GauravBhalla990/OpenSourceLidar/README.md

# OpenSourceLidar

Capstone Design Project (CSCE483 - Computer System Design): to build an open source lidar system.
