GauravBhalla990/OpenSourceLidar/Backup_Firmware/README.md

# Firmware for OpenSourceLidar - SF30C Backup Solution
Designing firmware code to flash onto Arduino and also to run ROS on Jetson to get hector slam map
through distance measurements from the SF30C and the encoder's motor speed values from the Encoder.
