GauravBhalla990/OpenSourceLidar/PCB_Firmware/README.md

# Firmware for OpenSourceLidar-OpenTOFPCB

The code in this folder details the scanning firmware to flash on to the MCU of the OpenTOF PCB through JTAG.
