GauravBhalla990/OpenSourceLidar/Backup_Firmware/Motor_encoder/README.md

# Firmware for OpenSourceLidar
Designing firmware code to run the 12V brushless DC motor
