GauravBhalla990/OpenSourceLidar/Documentation/Final/Final_Design_Presentation_Team_3N5.pdf

# Open Source LIDAR

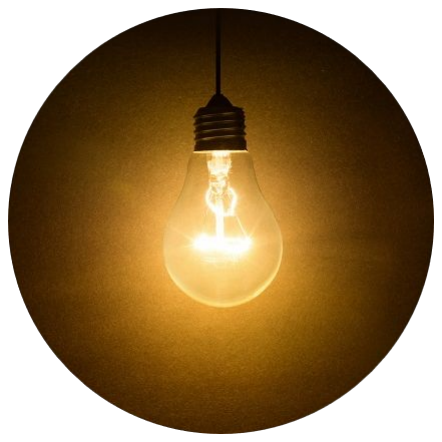
[picture p14: figure]

### Light Seekers

Paul Roy, Gaurav Bhalla, Allen Chen, Aamhish Rao

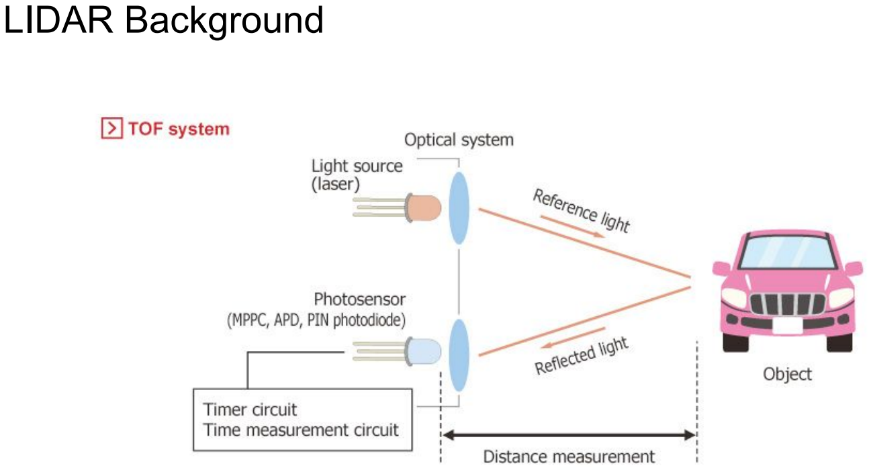
[picture p15: page 2]

### LIDAR Background

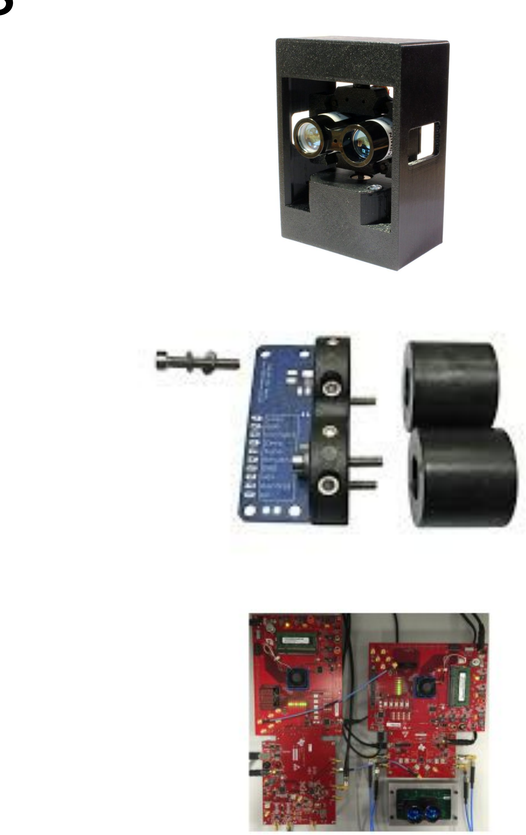
[picture p16: figure]

### Evaluation of Alternative Solutions

Xaxxon’s OpenLIDAR

OSLRF-01

TIDA-01187

Open Source LIDAR Unruly

### Problem Background

- Research group’s MEMS mirror is difficult to use.
- Commercial product do not have non-uniform sampling rate
- MEMS mirror create low and high speed areas of sampling

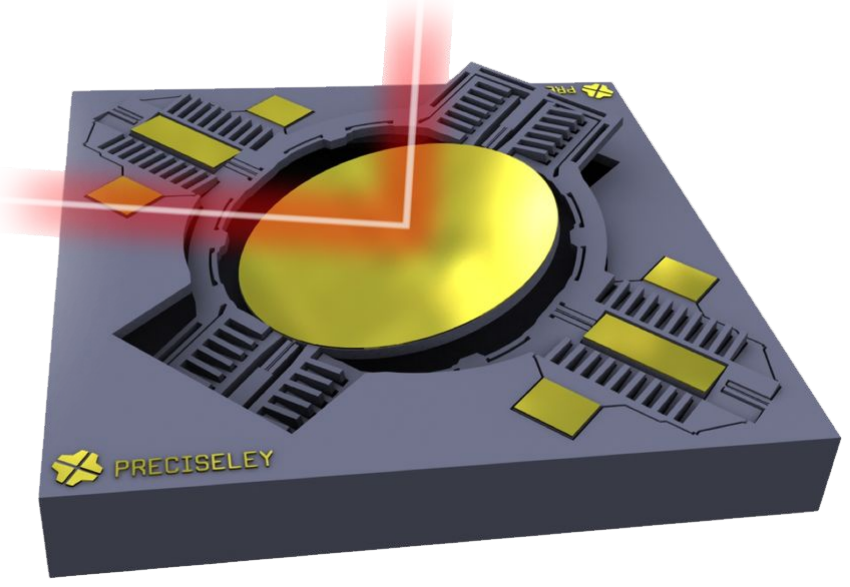
[picture p17: figure]

- We needed to copy this capability.

### Project Goals

- Recreate a working LIDAR system.
- Needed to sample space in a non-uniform manner.

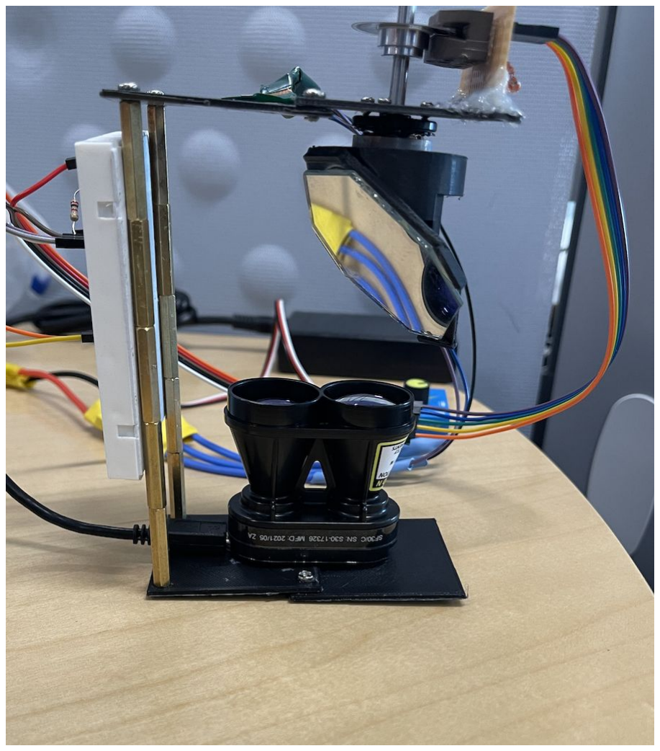
[picture p18: figure]

- Needed to create re-configurable design.

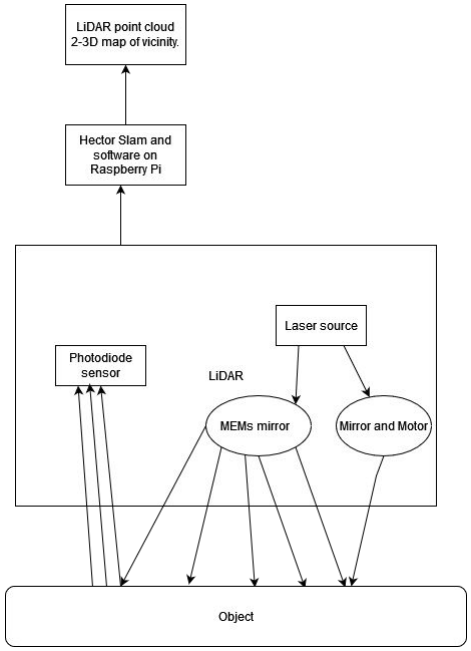
[picture p19: figure]

### System Design

- Lidar
- Laser source
- Spinning mirror
- Photodiode sensor
- Electronic and optical components

mounted on custom PCB board
- Post Processing
- Hector SLAM/ROS to read and

process lidar data

- Generate 2d/3d point cloud

### SF30C LIDAR Low Level Design

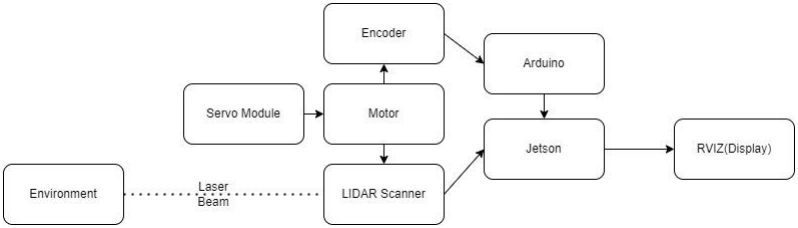
[picture p20: figure]

### Encoder

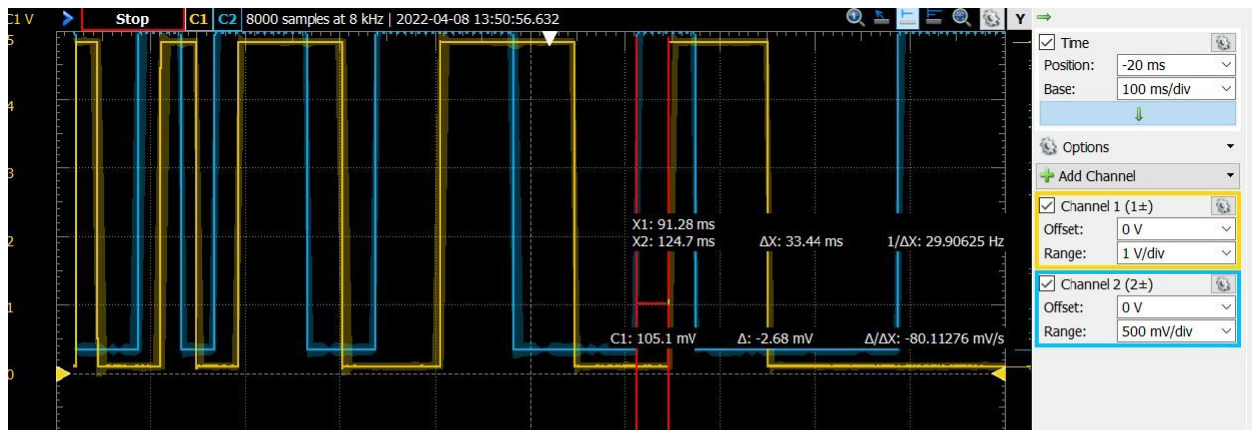
[picture p21: figure]
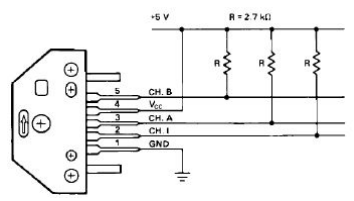
[picture p22: figure]

### Motor

- 12V LiPo Battery and ESC.

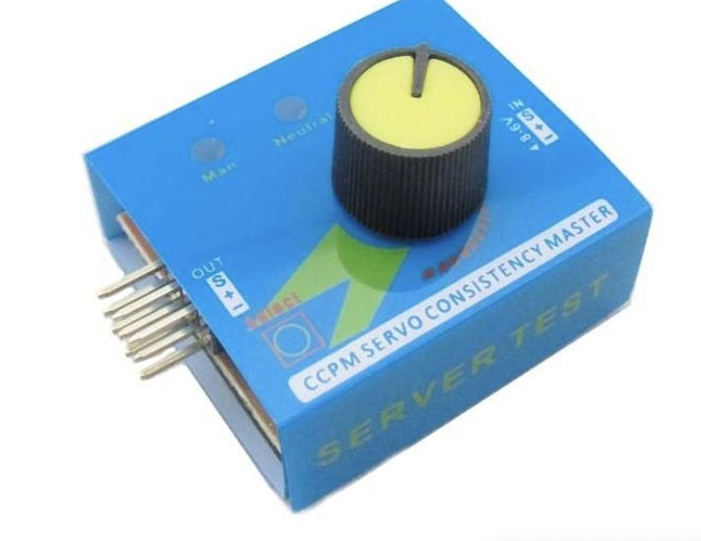
[picture p23: figure]

- Used Servo module to interface with ESC

and control motor with PWM.

- PID Loop with Encoder input and Motor

output.

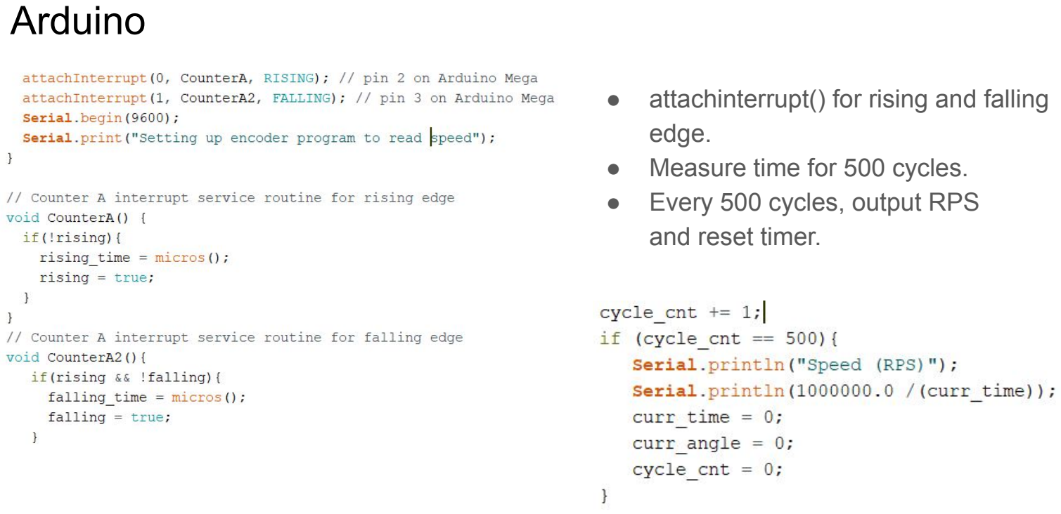
[picture p24: page 10]

### Arduino

- attachinterrupt() for rising and falling edge.
- Measure time for 500 cycles. ● Every 500 cycles, output RPS

and reset timer.

### Python ROS Programs

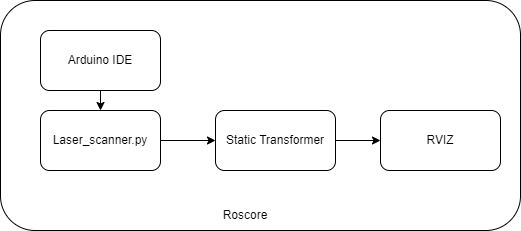
[picture p25: figure]

### LaserScanner

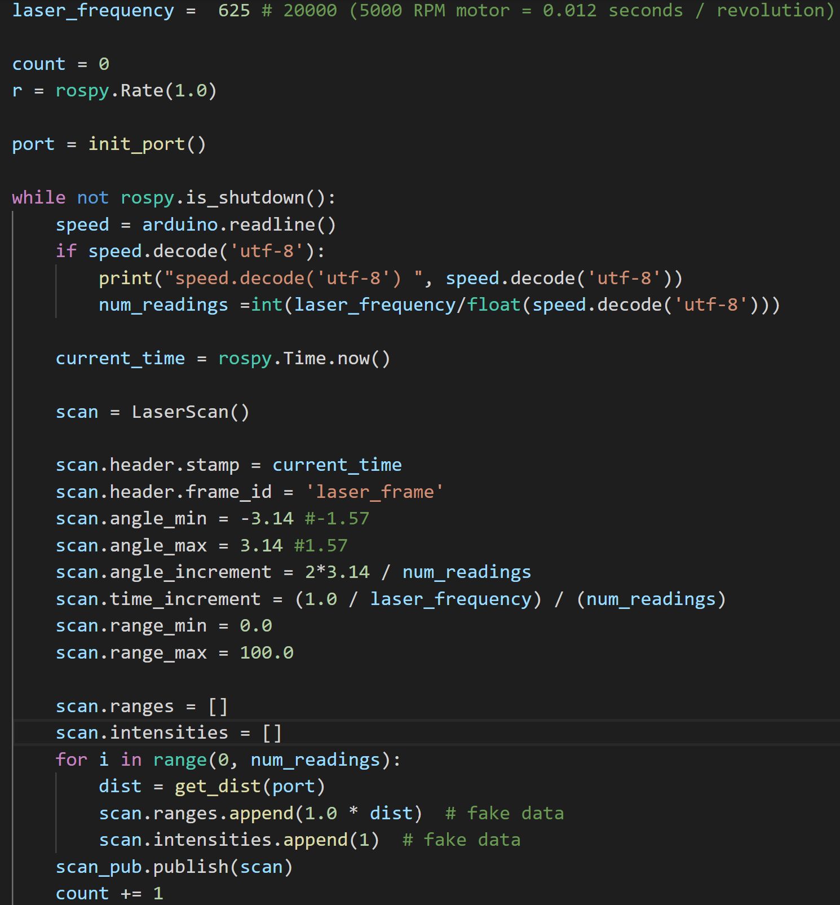
[picture p26: figure]

- Initialize serial port
- Initialize ROS node
- Receive code from Arduino and decode data
- Create laser scan message, setup params
- In readings loop append the ranges in sets
- Fill with fake data for intensities.

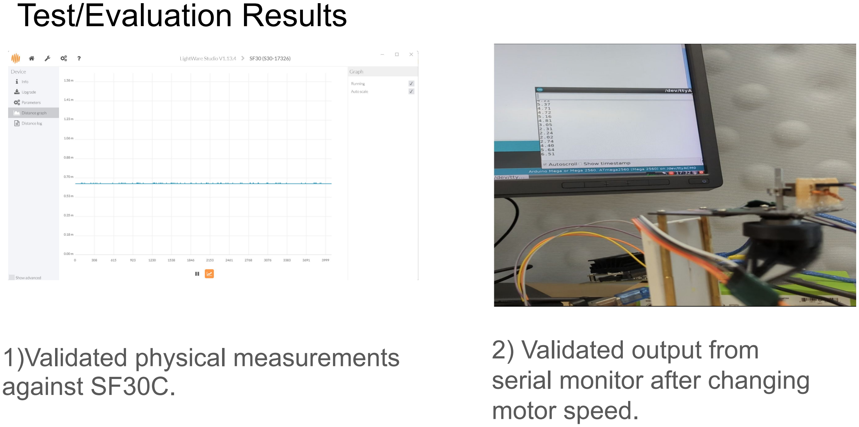
[picture p27: page 13]

### Test/Evaluation Results

1)Validated physical measurements against SF30C.

2) Validated output from
serial monitor after changing motor speed.

### Demonstration plan

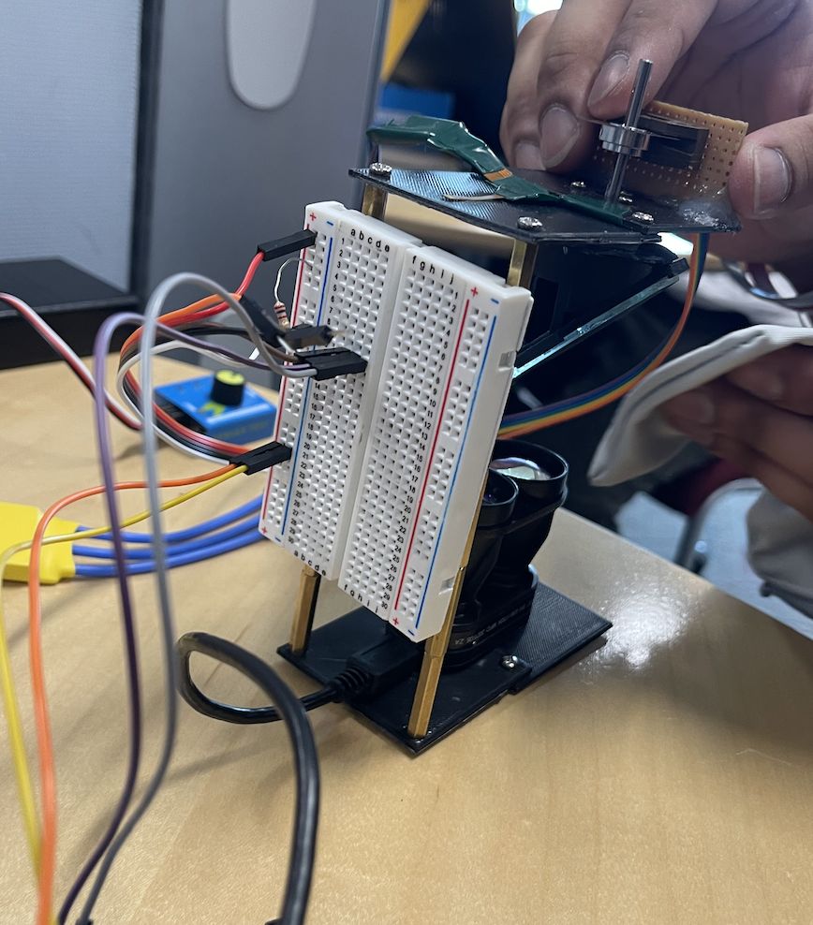
[picture p28: figure]

- Connect all of the components of the SF30

Lidar system.

- Power on battery
- Run python and arduino programs.
- Run RVIZ to see point cloud map of the

local area.

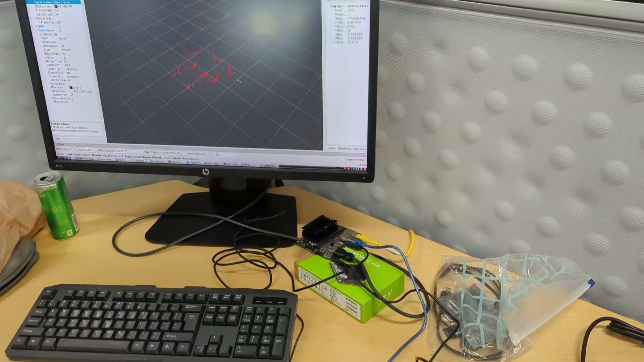
[picture p29: page 15]

### PCB Design Low Level Block Diagram

Author flashes firmware on the MCU.

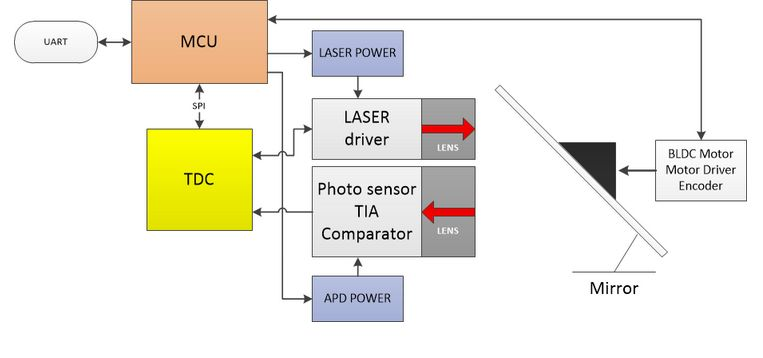
[picture p30: figure]
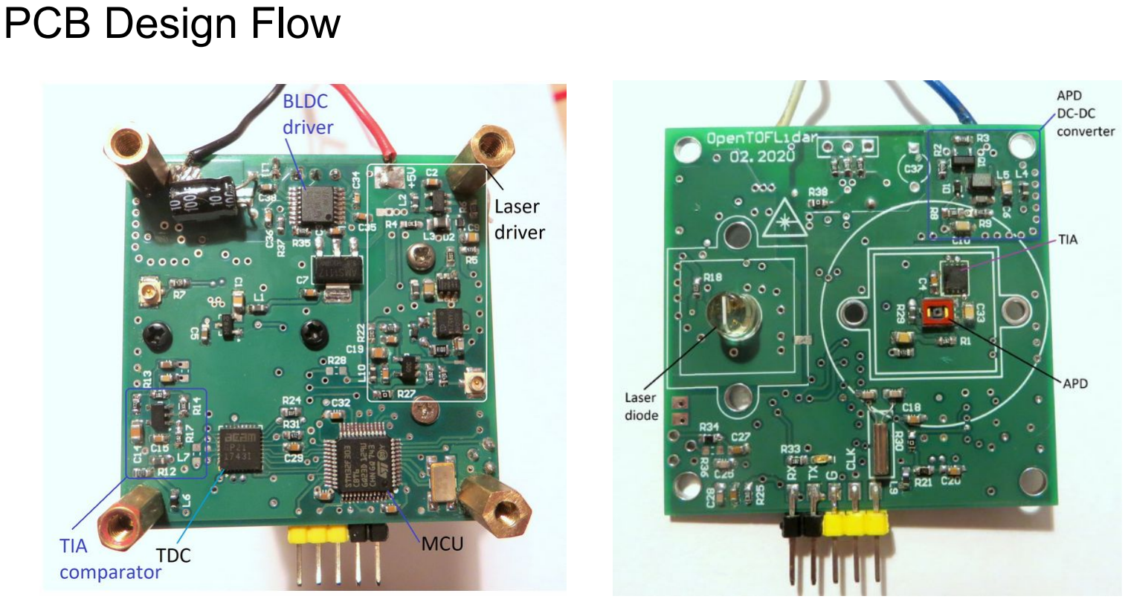
[picture p31: page 17]

### PCB Design Flow

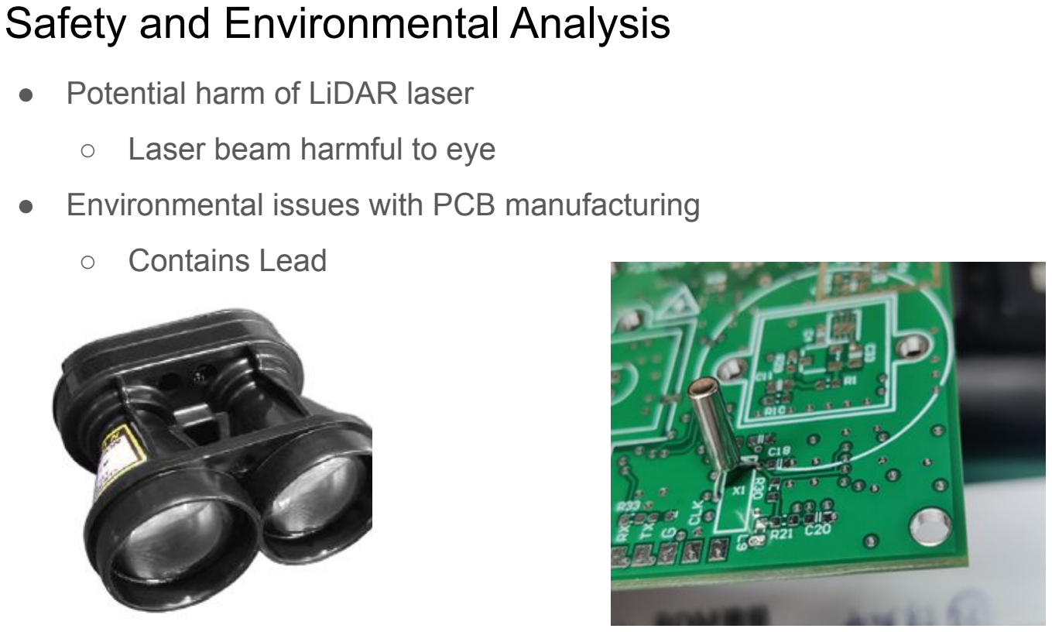
[picture p32: page 18]

### Safety and Environmental Analysis

- Potential harm of LiDAR laser
- Laser beam harmful to eye
- Environmental issues with PCB manufacturing
- Contains Lead

### Social, Political, Ethical Concerns

- Used for self-driving cars too early.

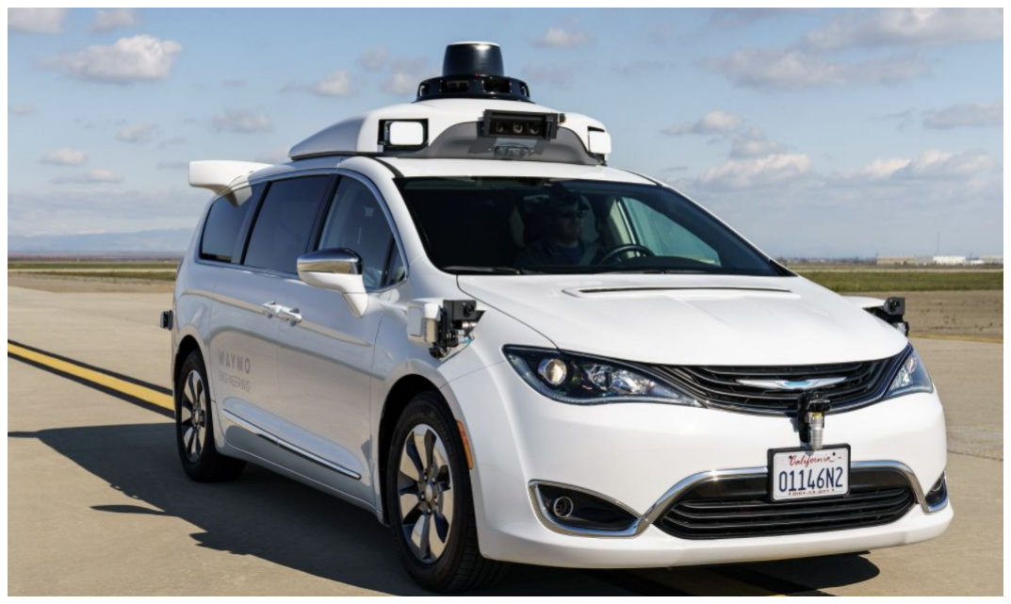
[picture p33: figure]

- Ethical, social and political issues in

Eastern Europe

- COVID outbreaks in China
- Lidar parts including the OpenTOF

PCB heavily delayed

### Manufacturability, Sustainability, and Economics

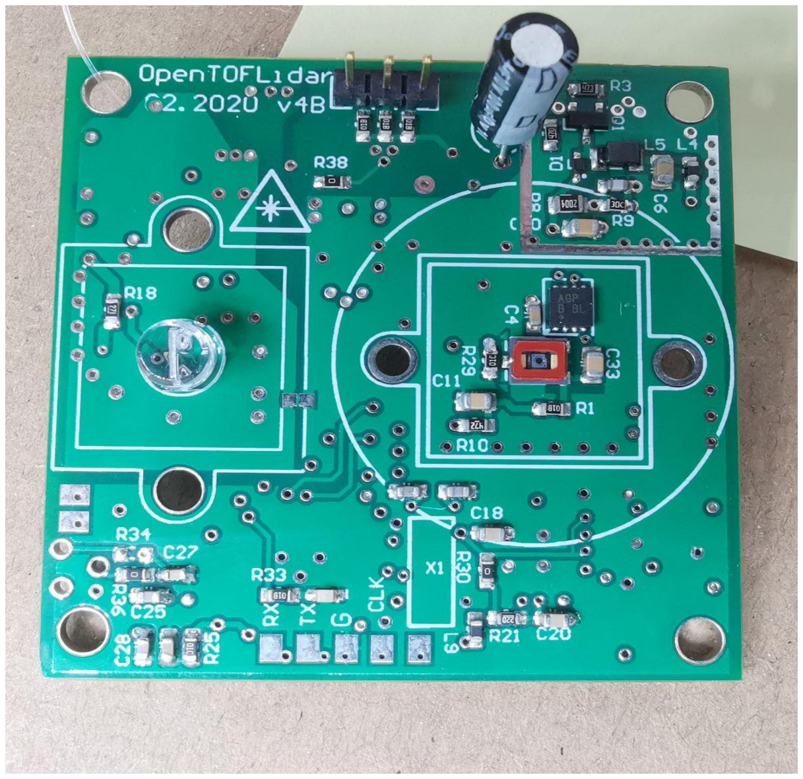
[picture p34: figure]

- PCB had a MOQ of 5.
- ~50 days to ship all PCB components.
- PCB uses some lead.
- SF30C PCB likely has lead.
- Total cost = $967.86 ($367.86 over budget)

### Project Management

- Two sub-teams: hardware and software
- Weekly meetings and occasional in-person meetings.
- Key meeting notes and weekly meeting reports
- Github

Q&A
