GauravBhalla990/OpenSourceLidar/Documentation/CDR/CDR_Presentation_Team3N5_LightSeekers.pdf

# Open Source LIDAR


## Light Seekers

Paul Roy, Gaurav Bhalla, Allen Chen, Aamhish Rao

## LIDAR Background



## Evaluation of Alternative Solutions

Xaxxon’s OpenLIDAR

OSLRF-01

TIDA-01187

Open Source LIDAR Unruly

## Problem Background

- Research group’s MEMS mirror is difficult to use.
- Commercial product do not have non-uniform sampling rate
- MEMS mirror create low and high speed areas of sampling


- We need to copy this capability

## Needs Statement

- Sample space in a non-uniform manner

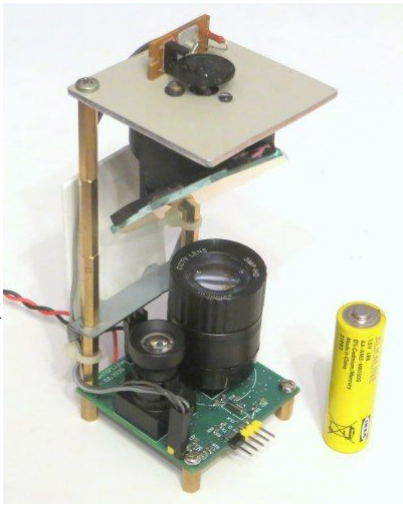
[picture p47: figure]

- Help research group to create novel LIDAR

## Goals And Objectives

Goal 1: Recreate a working Lidar system based on OpenTOFLidar

Goal 2: Develop a non-uniform sampling system

Goal 3: Create reconfigurable lidar system

## Specific Design Needs

- Increased sampling range
- Increased sampling rate

Possible Solutions for Non-uniform Sampling:

Region of Interest(ROI):

1. Uses object detection algorithms to identify areas of interest
2. Scan at a higher rate for objects expected to be more important/complex

Exciting but beyond the time scope of project.

Subsampling:

1. Scan the area once to identify general clusters
2. Scan a second time with more dynamic rates for the specific elements in the clusters themselves.

This method is simple but requires two scans to complete.


## System Design

- Lidar
- Laser source
- Spinning mirror
- Photodiode sensor
- Electronic and optical components

mounted on custom PCB board
- Post Processing
- Hector SLAM/ROS to read and

process lidar data

- Generate 2d/3d point cloud

## Low Level Block Diagram

Author configures MCU to run through the IAR Embedded Workbench.

We will flash the firmware on the MCU through Keil uVision.

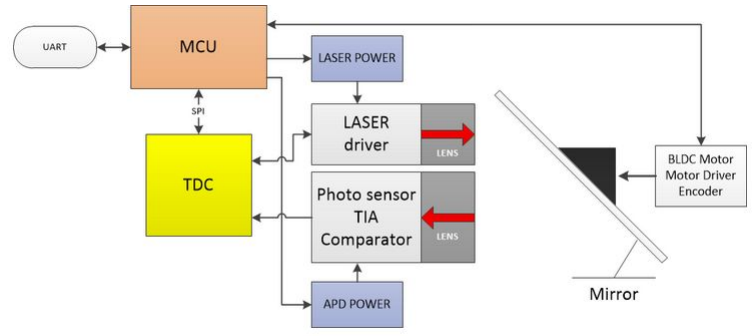
[picture p48: figure]

## PCB Design Flow (Top)

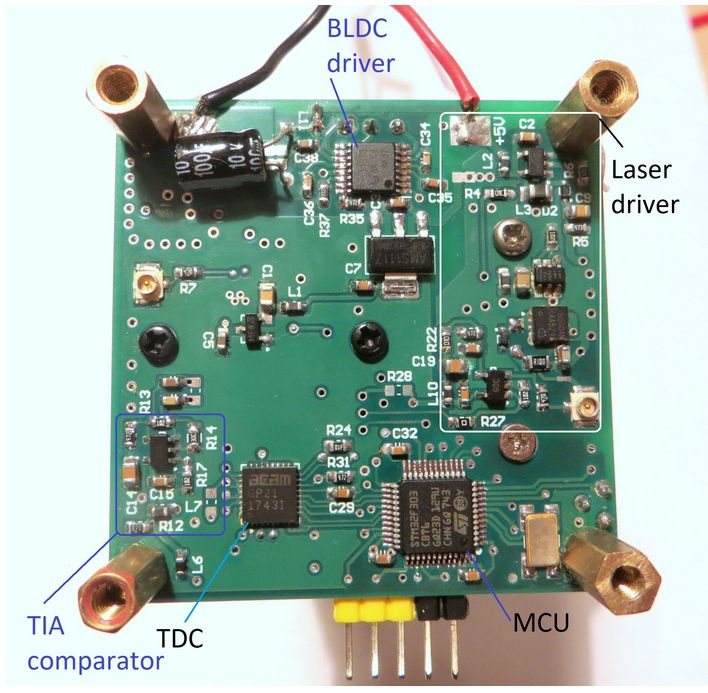
[picture p49: figure]

## PCB Design Flow (Bottom)

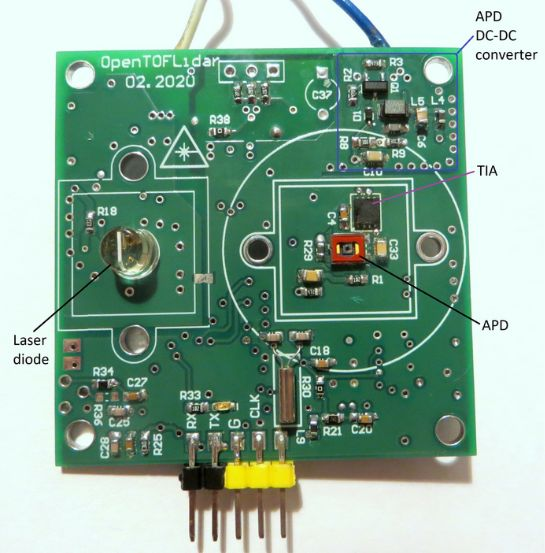
[picture p50: figure]

## Firmware


## Firmware - Main.C

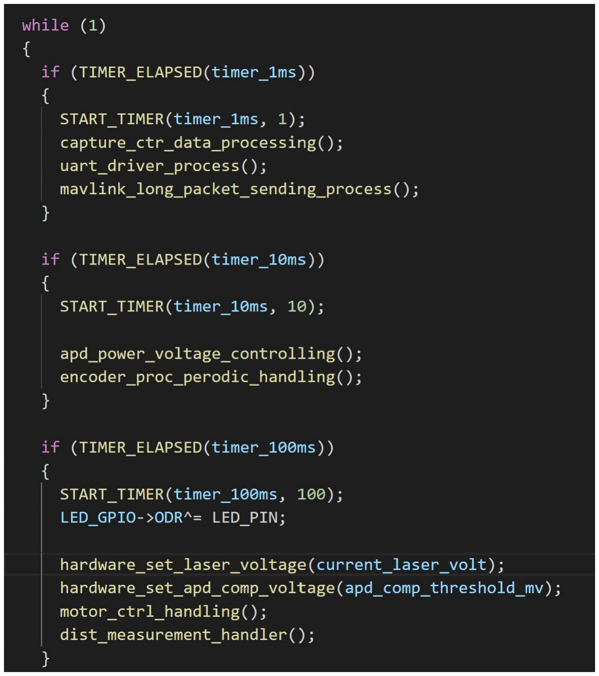
[picture p51: figure]

- Processes Data
- Sends Data through mavlink protocol
- Adjust Voltage based on light intensity
- Adjust Encoder if tick is out of range
- Flashes LED
- Sets Laser and Photodiode voltage
- Time of Flight
- Handle Motor Speeds

## Firmware - Capture_Controlling & Distance

- Captures the rotation of the encoder
- Initializes some timers for the encoder
- Keep track of the encoder periods and cycles, captures timer and encoder interrupt
- Periodically called to capture data from the lidar

## Firmware - Encoder & Motor

- Code from the Spec Sheet
- Simple Cycles for getting data from the encoder and setting PWM cycles for the motor controlling
- P loop for feedback from Encoder to control Motor

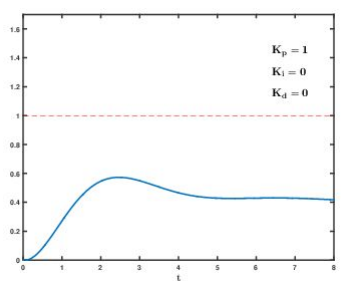
[picture p52: figure]
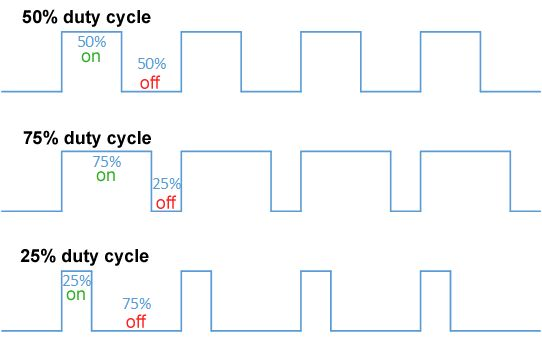
[picture p53: figure]

## Design Testing & Validation

- Test SF30C Lightware Lidar system against OpenTOF specs.
- Validate our model to Physical Distances
- Validate final design against Reference OpenTOF System
- Validate our Model’s parameters to benchmark

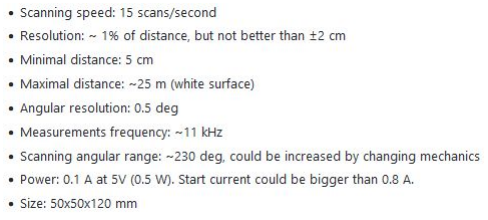
[picture p54: figure]

## Demonstration plan

1) Wear laser safety glasses.
2) Screen record laptop when code is flashed.
3) Also video record motorized spinning mirror.

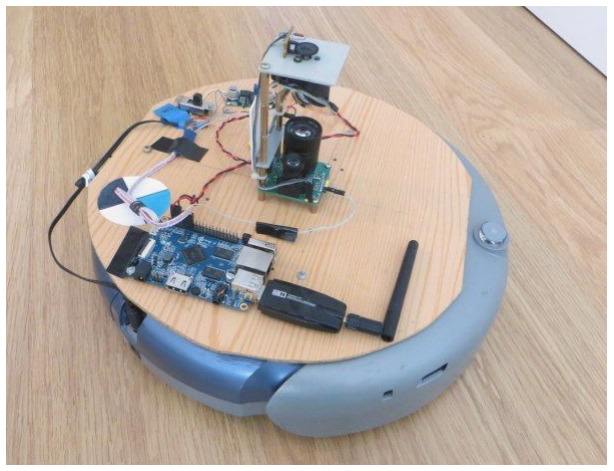
[picture p55: figure]

## Schedule of Tasks

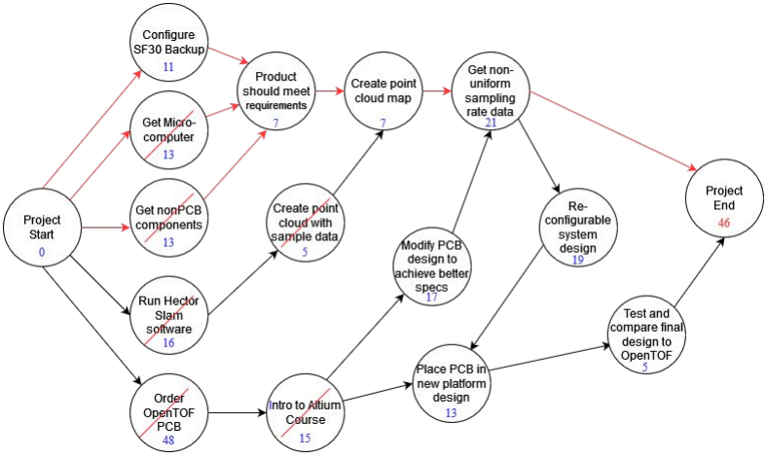
[picture p56: figure]

## Schedule of Tasks

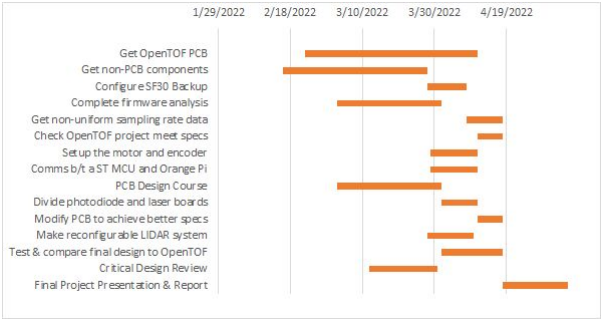
[picture p57: figure]

## Project Management and Teamwork

- Two sub-teams
- Weekly meetings and occasional in-person meetings
- Key meeting notes and weekly meeting reports
- Github

## Societal, Safety and Environmental Analysis

- Emerging applications in industry
- Potential harm of LiDAR laser
- Environmental issues with PCB manufacturing

## Social, Political, Ethical Concerns

- Used for self-driving cars too early.

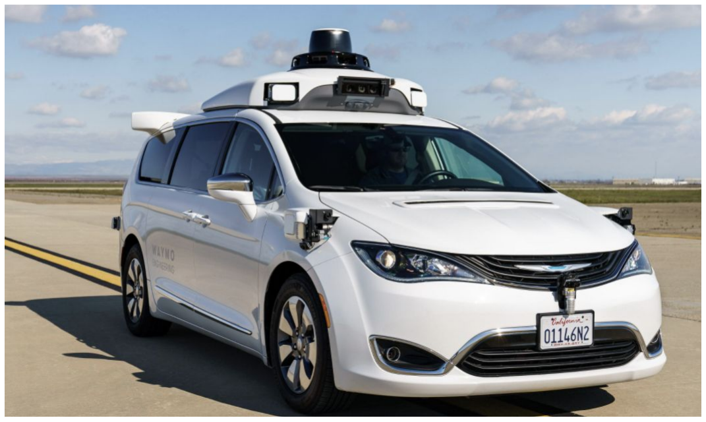
[picture p58: figure]

## Manufacturability, Sustainability, and Economics

- PCB had a MOQ of 5.
- 27 days to ship all PCB components.
- Correspondence with Engineer.
- PCB uses some lead.

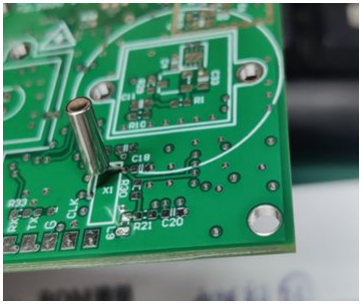
[picture p59: figure]
