GauravBhalla990/OpenSourceLidar/Backup_Firmware/old_python_ros_node/Untitled document (2).docx

https://answers.ros.org/question/371902/how-to-subscribe-to-laser-scan-topic-and-publish-a-customized-scan-topic-back/

https://gist.github.com/atotto/c47bc69a48ed38e86947b5506b8e0e61

https://python.hotexamples.com/site/file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

[ERROR] [1648931021.762483479]: [registerPublisher] Failed to contact master at [localhost:11311]. Retrying…

export ROS_MASTER_URI=http: (http://master:11311)//master:11311

https://lightwarelidar.com/products/sf40-c-100-m

~/path_to_your_workspace/devel/setup.bash

rosrun lightware_sf40_ros sf40_node /dev/ttyUSB0 115200 ?TM,360,0

terminate called after throwing an instance of 'serial::IOException'

what(): IO Exception (13): Permission denied, file /home/paul/catkin_ws/src/serial-main/src/impl/unix.cc, line 151.

Aborted (core dumped)

[ERROR] [1648936678.063308811]: Error 2 opening : No such file or directory

sudo chown paul /dev/ttyUSB0

git clone https://bitbucket.org/castacks/sf30_node.git

roslaunch sf30_node sf30.launch

http://wiki.ros.org/sf30_node

https://hackersgrid.com/2017/08/how-to-install-and-setup-linux-in-orange-pi-r1.html

https://github.com/LightWare-Optoelectronics/SampleLibrary/blob/master/sf30_arduino_serial/sf30_arduino_serial.in

#!/usr/bin/env python

2 (http://wiki.ros.org/ROS/Tutorials/WritingPublisherSubscriber%28python%29) # license removed for brevity

3 (http://wiki.ros.org/ROS/Tutorials/WritingPublisherSubscriber%28python%29) import rospy

4 (http://wiki.ros.org/ROS/Tutorials/WritingPublisherSubscriber%28python%29) from std_msgs.msg import String

5 (http://wiki.ros.org/ROS/Tutorials/WritingPublisherSubscriber%28python%29)

6 (http://wiki.ros.org/ROS/Tutorials/WritingPublisherSubscriber%28python%29) def talker():

7 (http://wiki.ros.org/ROS/Tutorials/WritingPublisherSubscriber%28python%29) pub = rospy.Publisher('chatter', String, queue_size=10)

8 (http://wiki.ros.org/ROS/Tutorials/WritingPublisherSubscriber%28python%29) rospy.init_node('talker', anonymous=True)

9 (http://wiki.ros.org/ROS/Tutorials/WritingPublisherSubscriber%28python%29) rate = rospy.Rate(10) # 10hz

10 (http://wiki.ros.org/ROS/Tutorials/WritingPublisherSubscriber%28python%29) while not rospy.is_shutdown():

11 (http://wiki.ros.org/ROS/Tutorials/WritingPublisherSubscriber%28python%29) hello_str = "hello world %s" % rospy.get_time()

12 (http://wiki.ros.org/ROS/Tutorials/WritingPublisherSubscriber%28python%29) rospy.loginfo(hello_str)

13 (http://wiki.ros.org/ROS/Tutorials/WritingPublisherSubscriber%28python%29) pub.publish(hello_str)

14 (http://wiki.ros.org/ROS/Tutorials/WritingPublisherSubscriber%28python%29) rate.sleep()

15 (http://wiki.ros.org/ROS/Tutorials/WritingPublisherSubscriber%28python%29)

16 (http://wiki.ros.org/ROS/Tutorials/WritingPublisherSubscriber%28python%29) if __name__ == '__main__':

17 (http://wiki.ros.org/ROS/Tutorials/WritingPublisherSubscriber%28python%29) try:

18 (http://wiki.ros.org/ROS/Tutorials/WritingPublisherSubscriber%28python%29) talker()

19 (http://wiki.ros.org/ROS/Tutorials/WritingPublisherSubscriber%28python%29) except rospy.ROSInterruptException:

20 (http://wiki.ros.org/ROS/Tutorials/WritingPublisherSubscriber%28python%29) pass

http://cobecoballes-robotics.blogspot.com/2018/08/laserscan-ros-arduino.html

scan.header.frame_id = 'laser'

scan.header.stamp = get_most_recent_timestamp(rf, sg)

scan.angle_min = angle_min

scan.angle_max = angle_max

scan.angle_increment = angle_increment

scan.scan_time = time.time() - last_scan_time

scan.time_increment = scan.scan_time / 541

scan.range_min = rf.range_min

scan.range_max = rf.range_max

scan.ranges = rf.ranges

for i in range(180*2):

if sg.ranges[i] < scan.ranges[90 + i] or scan.ranges[90 + i] == 0:

scan.ranges[90 + i] = sg.ranges[i]
