GauravBhalla990/OpenSourceLidar/Documentation/Final/Bill_of_materials_team3N5.xlsx

IGNORE ITEMS HIGHLIGHTED IN YELLOW AS THEY WERE INCLUDED IN THE PCB COST | No. | Name | Retail Price $ | Description | Taobao Price ¥ | Note | Taobao URL | URL
PCB components | 1 | AD500-8 | $10.40 | Chinese Avalanche photodiode (proved in real device), TO-52 package. Original photodiode costs $180 at Mouser | 65 |  | 【淘宝】https://m.tb.cn/h.fPxuv8d?tk=ZQRx23eDqGc「AD500-8雪崩光电二极管 TO52S1 激光测距用 AD500-8 TO52S1雪崩管」 | https://aliexpress.com/item/1298052194.html
 | 2 | SPL PL90_3 | $9.44 | Pulsed Laser Diode | 59 |  | 【淘宝】https://m.tb.cn/h.fmx7VW4?tk=7Ohx23eBbI5「SPLPL90-3 SPL PL90-3 脉冲激光二极管 75W 905NM 全新原装进口」 | https://aliexpress.com/item/32817685030.html
 | 3 | MAX3658 | $4.80 | Transimpedance Amplifier | 30 |  | 【淘宝】https://m.tb.cn/h.fmTBQiq?tk=lJuv23GNy9B「MAX3658AETA MAX3658 TDFN-8 芯片」 点击链接直接打开 | https://www.digikey.com/product-detail/en/maxim-integrated/MAX3658AETA-T/MAX3658AETA-TCT-ND/5404197
 |  |  | $0.00 | (22$ for 5 pcs) |  |  |  | https://www.ebay.com/itm/5PCS-MAX3658AETA-T-IC-AMP-TRANSIMPEDANCE-8-TDFN-MAX3658-3658-MAX3658A-3658A-MAX3/192826918497
 | 4 | ADCMP600 x 2 | $3.20 | Fast Comparator, two IC | 20 |  | 【淘宝】https://m.tb.cn/h.fNTNldS?tk=SumS23GM1U6「ADCMP600BRJZ ADCMP600BKS ADCMP600BRJ ADCMP600 SOT23-5 芯片」 点击链接直接打开 | https://www.digikey.com/product-detail/en/analog-devices-inc/ADCMP600BKSZ-REEL7/ADCMP600BKSZ-REEL7CT-ND/1246113
 |  |  | $6.08 |  | 38 |  | 【淘宝】https://m.tb.cn/h.fmTBgEM?tk=ntUm23GoMYd「雷顿 ADCMP600BKSZ ADCMP600 丝印G0C SC70-5线性比较器 原装」
 | 5 | UCC27511DBVR | $3.81 | Mosfet Driver | 23.8 | 10 pc | 【淘宝】https://m.tb.cn/h.flTAGAP?tk=ANQL23GKzja「UCC27511DBVR UCC27511DBV UCC27511DBVT 7511 全新正品可拍」 点击链接直接打开 | https://www.digikey.com/product-detail/en/texas-instruments/UCC27511DBVR/296-30285-1-ND/3060762
 |  |  | $16.00 |  | 100 |  | 【淘宝】https://m.tb.cn/h.fNToX5Y?tk=lxC623GpOpJ「原装正品 UCC27511DBVR 封装SOT-23-6 丝印7511 MOS驱动器 贴片」 点击链接直接打开
 | 6 | TDC-GP21 | $2.00 | Time-to-Digital converter IC | 12.5 |  | 【淘宝】https://m.tb.cn/h.fm6ZTNL?tk=IHoA23GJb8n「TDC-GP21 丝印:GP21 QFN-32 流量传感芯片 传感器探测器接口IC」 点击链接直接打开 | https://www.ebay.com/itm/1pcs-TDC-GP21-GP21-new/292575333067
 | 7 | STM32F303CBT6 | $8.48 | MCU | 53 |  | 【淘宝】https://m.tb.cn/h.fNTpQoi?tk=hQdW23GJp2G「全新原装STM32F303CBT6 LQFP-48 ARM Cortex-M4 32位微控制器-MCU」 点击链接直接打开 | https://www.digikey.com/product-detail/en/stmicroelectronics/STM32F303CBT6/497-17421-ND/4357226
 | 8 | DRV11873PWPR | $6.40 | DLDC driver DRV11873 | 40 |  | 【淘宝】https://m.tb.cn/h.fOUwAur?tk=aoGC23GIgGm「DRV11873PWPR DRV11873PW DRV11873 封装HTSSOP16 全新原装」 点击链接直接打开 | https://ru.mouser.com/ProductDetail/Texas-Instruments/DRV11873PWPR
 |  |  | $0.00 | DLDC driver DRV11873 (China, 1$) |  |  |  | https://aliexpress.com/item/33010069942.html
 | 9 | BSZ165N04NS G | $0.40 | Fast MOSFET | 2.5 |  | 【淘宝】https://m.tb.cn/h.fOUwCbQ?tk=BHUU23GIsqJ「BSZ165N04NS G 165N04N MOSFET 40V/31A SON-8 进口原装 支持配单」 点击链接直接打开 | https://ru.mouser.com/ProductDetail/Infineon-Technologies/BSZ165N04NSGATMA1
 | 10 | Additional PCB components | $8.00 |  | 50
 | 11 | PCB Itself | $2.40 | 4 Layer PCB, price for 5 boards (<50x50mm) | 15 |  |  | https://jlcpcb.com
 |  |  | $0.00
 | 12 | Photodiode Lens | $4.48 | Lens, CS mount, 25mm focal length, F1.2 | 28 |  |  | https://aliexpress.com/item/32303375838.html
 | 13 | CS lens holder | $0.24 | Holder for CS lens | 1.5 |  | 【淘宝】https://m.tb.cn/h.fNTqmms?tk=SyBE23GHtNo「CS金属镜头底座20mm安装孔距安防监控摄像机配件CS镜头座」 点击链接直接打开 | https://aliexpress.com/item/32815023477.html
 | 14 | BLDC motor | $0.64 | BLDC, outrunner, 20mm diameter, KV > 200 | 4 |  | 【淘宝】https://m.tb.cn/h.fm6chvO?tk=733o23GF56t「【仓兴达】高速云台电机 2010 无刷电机 KV值2500 滚珠轴承」 点击链接直接打开 | https://aliexpress.com/item/4000323714513.html
 | 15 | Scanning Mirror | $1.60 | Customized shape, Alum, front surface mirror (12$ for 4 mirrors) | 10 |  | 【淘宝】https://m.tb.cn/h.fOUAm6T?tk=S1yH23Gw2a1「无框大块钢化玻璃镜子定制切割鞋柜玻璃镜面定做防爆贴墙小镜子片」 点击链接直接打开 | https://aliexpress.com/item/4000246071735.html
 |  |  | $4.80 | soft mirror | 30 |  | 【淘宝】https://m.tb.cn/h.fl63whX?tk=HLhs23Gx2ry「软镜子 超薄手工镜子diy材料镜子贴安全不碎非玻璃软镜子可剪切」
 | 16 | Stand-offs | $1.28 | 25mm M3 Hex Stand-off x 8, price for 20pcs | 8 | 10 male | 【淘宝】https://m.tb.cn/h.fl6V45D?tk=5gSm23GBfNx「六角铜柱 单头铜螺柱 25mm铜柱 隔离机箱铜柱 铜柱螺母 铜柱M3」 点击链接直接打开 | https://www.aliexpress.com/item/4000449592477.html
 |  |  | $0.24 |  | 1.5 | 5 female | 19微子那可地有一小多着这为信 https://m.tb.cn/h.fNTG5K5 ~这个商品很不错，我还有一张【3】元，限量优惠I券送给你，快来看看！【(5个)M3*25mm 双通六角铜柱 电脑机箱主板螺丝母杆钉子紧固隔离】
 |  | Stand-offs | $0.00 | 10mm M3 Hex Stand off
 | 17 | Laser lens | $4.80 | 25mm M12 F2.0 lens (Free delivery) | 30 |  | 【淘宝】https://m.tb.cn/h.fNTuGhR?tk=SI0h23uZAjO「500万高清镜头4mm6mm8mm12mm16mm25mm1/2.5英寸M12口监控器材配件」 点击链接直接打开 | https://aliexpress.com/item/32913215547.html
 |  |  | $2.96 |  | 18.5 |  | 【淘宝】https://m.tb.cn/h.fl6U6sX?tk=zIgO23u0t1z「3MP 25mm小镜头300万25MM数字高清镜头M12单扳机25毫米远焦镜头」 点击链接直接打开
 |  |  | $2.88 |  | 18 |  | 【淘宝】https://m.tb.cn/h.fm64kBz?tk=mevI23ub0ty「25mm高清监控摄像机定焦镜头单板机红外镜头长焦镜头m12镜头」
 | 18 | Laser lens holder | $0.16 | Plastic holder, 10mm height, 20mm hole distance (price for 10pcs) | 1 |  | 【淘宝】https://m.tb.cn/h.fNTvrDI?tk=J19J23u1Ypu「M12镜头座20mm安装孔距7 8 10 14 15mm高塑钢金属塑料小镜头座」 点击链接直接打开 | https://aliexpress.com/item/32953675441.html
 |  |  | $0.16 |  | 1 |  | 【淘宝】https://m.tb.cn/h.fNTvrDI?tk=J19J23u1Ypu「M12镜头座20mm安装孔距7 8 10 14 15mm高塑钢金属塑料小镜头座」
 | 19 | M12 lens adapter | $0.19 | Price for 1pcs | 1.2 |  | 【淘宝】https://m.tb.cn/h.fm6f8Fw?tk=UMC623u1y79「小镜头增高环 延长环 M12小镜头加高座 变长环 增高座总长10MM」 点击链接直接打开 | https://aliexpress.com/item/32962439240.html
 |  |  | $0.48 |  | 3
 |  |  | $0.00 |  |  |  | 【淘宝】https://m.tb.cn/h.fm65WEC?tk=6qyr23u1aRV「M12*0.5镜透增高环 转接圈 延长圈 镜头座加高神器」 点击链接直接打开
 |  |  | $0.00
 |  |  | $0.00 | Note - this total price is calculated without delivery price
 |  |  | $0.00
 |  |  | $0.00
 | _1_ | [AD500-9 TO52S1F2] | $0.00 | Chinese Avalanche photodiode (NOT proved but similar to AD500-8), TO-52 package, interated interference filter | 0 | with filter | 【淘宝】https://m.tb.cn/h.fm65y0n?tk=oIHy23uX9b7「AD500-9 TO52S1F2 APD雪崩光电二极管 905nm 带滤光片 全新原装」 点击链接直接打开 | https://aliexpress.com/item/32735300921.html (https://aliexpress.ru/item/32735300921.html)
 |  |  | $0.00 |  | 0 | without filter
 | _1_ | [MTAPD-07-013] | $0.00 | Original Avalanche photodiode (proved), 3-LCC package | 0 |  | 【淘宝】https://m.tb.cn/h.fNTDkj9?tk=TCMj23u279q「MTAPD-07-013 [M] SENSOR PHOTODIODE 905NM LCC-3」 | https://www.digikey.com/products/en?keywords=MTAPD-07-013
 |  | Interference Filter | $0.00 | Optional Interference Filter, 905 +-10nm |  |  |  | https://www.ebay.com/itm/Optical-Filter-905nm-band-pass-filter-895nm-915nm-Dia-11-5mm/262976990433
 |  | Interference Filter | $0.00 | Optional Interference Filter, 905 +-5nm, Free delivery | 0 | diameter 11.5mm, thickness 1mm | 【淘宝】https://m.tb.cn/h.fNTCf51?tk=lSQX23ud7kq「905nm窄带滤光片滤波镜片 微光夜视红外光通光镜面玻璃材质可定制」 点击链接直接打开 | https://aliexpress.com/item/32963619780.html (https://aliexpress.ru/item/32963619780.html)
 |  |  | $7.51 |  | 46.96 | x2 | 【淘宝】https://m.tb.cn/h.fl6Sey5?tk=zWB723u3emY「窄带滤光片785nm 808nm 830nm 850nm940nm980nm窄波段带通滤光片」 点击链接直接打开
 |  |  | $0.00
 |  | Optical Encoder Disk | $55.19 | HEDS-5140#A11 | newark.com |  |  | https://www.newark.com/broadcom/heds-5140-a11/code-wheel-500ppr-3ch-4mm/dp/58Y4782?CMP=AFC-OP
 |  | Optical Encoder | $54.00 | HEDS-9140#A00 | 93 | x2 |  | https://www.digikey.com/en/products/detail/broadcom-limited/HEDS-9140-A00/1001290
 |  | Laser Safety Glasses | $16.86 | 905nm protect eyes. 7 for everyone | 105.4 | x7
 |  | PCB Assembly | $30.00 | PCBway
 |  | PCB Manufacturing | $49.00 | PCBway
 |  | PCB Components | $170.00 | PCBway
 |  | Perfboard (ensure material is Fr-2 or Fr-4 not metal)https://learn.adafruit.com/collins-lab-breadboards-and-perfboards/learn-more | $14.99 | min. dimensions (W by L) - 1" by 2" or 4cm by 6cm |  |  |  | https://www.amazon.com/AiTrip-Perfboard-Breadboard-Prototyping-Electronic/dp/B07XYL451Y
 |  | breadboard jumper wires | $7.99 | 10 breadboard jumper wire cables of female-female, 10 male-female, and 10- |  |  |  | https://www.amazon.com/Elegoo-EL-CP-004-Multicolored-Breadboard-arduino/dp/B01EV70C78
 |  | HiLetgo CP2102 USB 2.0 to TTL Module Serial Converter Adapter Module USB to TTL Downloader | $0.00 | Not necessary for now. |  |  |  | https://www.amazon.com/IZOKEE-CP2102-Converter-Adapter-Downloader/dp/B07D6LLX19
 |  | Orange Pi | $39.44 | https://www.taobao.com/list/item/666143511704.htm?spm=a21wu.10013406.taglist-content.2
 |  | Glass cutter | $12.96
 |  | Glass cutter oil | $9.98
 |  | M3 Screws | $6.48
$967.86 |  | PWM Driver | $13.99 |  |  |  |  | https://www.amazon.com/Acxico-High-Power-Brushless-Controller-Regulator/dp/B0863HZN9L
 |  | Step up Converter | $10.89 |  |  |  |  | https://www.amazon.com/Aceirmc-Current-Converter-Adjustable-Regulator/dp/B082XQC2DS?th=1
 |  | SD Card | $7.98 |  |  |  |  | https://www.walmart.com/ip/onn-128GB-Class-10-U3-V30-MicroSDXC-Flash-Memory-Card-with-Adapter/772835319
 |  | Power Supply | $11.99 |  |  |  |  | https://www.amazon.com/Power-Supply-Lights-Adapter-Transformer/dp/B07GFFG1BQ?th=1
 |  | Male to Male plug Adapter | $6.99 |  |  |  |  | https://www.amazon.com/RLECS-5-5x2-1mm-Connector-Female-Adapter/dp/B07XDTDMVJ
 |  | DC Pigtails Cable | $10.81 |  |  |  |  | https://www.amazon.com/Pigtails-Female-Connector-Pigtail-Security/dp/B08PYWN3T7
 |  | Rechargable Battery Pack | $28.99 |  |  |  |  | https://www.amazon.com/TalentCell-Rechargeable-3000mAh-Lithium-External/dp/B01M7Z9Z1N
 |  | Jetson Hat | $16.99 |  |  |  |  | https://www.amazon.com/MakerFocus-Resolution-Interface-Compatible-Raspberry/dp/B07H9ZTWNC
 |  | Ratchet | $16.99 |  |  |  |  | https://www.amazon.com/MulWark-Profile-Ratchet-Quarters-Screwdriver/dp/B07D4DZB1T
 |  | Arduino Mega | $35.93 |  |  |  |  | https://www.amazon.com/ARDUINO-MEGA-2560-REV3-A000067/dp/B0046AMGW0
 |  | Hex Standoffs | $7.99 |  |  |  |  | https://www.amazon.com/Hxchen-Female-Hexagon-Standoff-Pillars/dp/B07WKL7TF1?th=1
 |  | SF30C | $299.00
