GauravBhalla990/OpenSourceLidar/(list of files, drawings)

Other design files:
ModifiedPCB/Modded_Lidar/Mod_OpenTOF.SchDoc
ModifiedPCB/Modded_Lidar/Mod_PCB_layout.PcbLib
ModifiedPCB/Modded_Lidar/Mod_TOF_RangeFinder.PcbDoc
ModifiedPCB/Modded_Lidar/Modded_TOF_RangeFinder.PrjPcb
ModifiedPCB/Modded_Lidar/Schlib_modded.SchLib
ModifiedPCB/OpenTOF_PCB_project_v4/PCB1.PcbDoc
ModifiedPCB/OpenTOF_PCB_project_v4/Sheet1.SchDoc
ModifiedPCB/OpenTOF_PCB_project_v4/TOF_rangefinder.PrjPcb
ModifiedPCB/PCB_Project_1/LED.PcbDoc
ModifiedPCB/PCB_Project_1/LED_example.SchDoc
ModifiedPCB/PCB_Project_1/LED_PcbLib.PcbLib
ModifiedPCB/PCB_Project_1/LED_Schlib.SchLib
ModifiedPCB/PCB_Project_1/PCB_Project_1.PrjPcb
ModifiedPCB/PCB_Project_1/Sheet3.SchDoc
